karteck/rover-autonome/README.md

# rover-autonome
Devellopement d'un rover autonome dans le cadre de l'alternance au Lab-STICC lors du Master 2
