karteck/rover-autonome/rosbag/README.md

## Description des rosbag enregistrées

|Nom|Description|
|---|---|
|imu1_data.bag & imu2_data.bag|Enregistrement de 3 heures avec deux centrales MPU6050 différentes, immobiles, et côtes à côtes.|

kjjtyfkgfhg
