karteck/rover-autonome/archive/Document de dev/Débogage robot alu.docx

Ludovic Chavalarias, Lab-STICC, 2022

# Débogage

## Marquer les zones inconnue d’une carte comme infranchissable

Dans le fichier « base_local-planner_default_params.yaml », ajouter la ligne allow_unknown : false. Cela a pour effet d’interdire la planification de trajet à travers les zones inconnue de la carte. Dans le labo, cela est utile au niveau des vitres.

Dans le fichier « cosmap_common_params.yaml » ajouter une « layer » :

obstacle_layer :

observation_sources : scan

scan :

data_type : LaserScan

topic : scan

marking : true

clearing : true

track_unknown_space : true

## Augmenter la sécurité du robot

Jouer avec les parametres inflation_radius et cost_scaling_factor afin d’augmenter la distance au obstacles.

Augmentation aussi de l’empreinte du robot pour ajouter une distance de « sécurité ». De manière général, l’empreinte devrait toujours être un peu plus grande que le robot lui-même.

## Paquet waypoints saute des points

On détermine à quoi serve les topics :

/waypoint_server/statusgoal | Indique si le l’objectif actuel est un succès ou non. Reçois un message seulement pour indiquer si est but est accomplis ou non. Ne reçois pas de message pendant l’accomplissement de l’objectif.
/waypoint_server/waypoints
/waypoint_server/waypoints_gr | Nom du groupe et liste des points que le robot est en train de parcourir
/move_base/current_goal | Position que le robot veut atteindre. Reçois un message à chaque nouvelle objectif reçu
/move_base/result | Indique qu’un objectif ait été atteint (status = 3)
/move_base/status | Liste de status de l’objectif actuel : - 1 : objectif accepté - 4 : abandon après que toutes les tentatives de déblocages aient échouées
/move_base/recovery_status | Reçois des messages lorsque des tentatives de déblocage sont en cours.

Observation : Dans le fichier tour_bug_skipEtRecovery.bag, le bug peut être observé, c’est le point au niveau de la pause IRDL qui est sauté. Lorsque le robot arrive au point de passage le précédent, le topic /move_base/status comporte deux entrées : reached et goal accepted. Cependant il comporte ensuite 3 entrées : deux reached et une goal accepted. Cela confirme que le point est accepté puis directement considérer comme atteint

Résolution :

Problème similaire : https://github.com/ros-planning/navigation/issues/949

On fait les modifications du lien au-dessus dans les fichier move_base.cpp et move_base.h

## Le robot est bloqué à un point et les resets ne fonctionnent pas

- amcl.launch
  - laser_likeihood_max_dist = 4 from 2
  - laser_siglma_hit = 0.1 from 0.2
  - laser_z_hit = 0.9 from 0.5

Il se peut que les costmap ne soit pas réellement reset lors des tentatives de recovers. Dans le fichier tour_bug_skipEtRecovery.bag le bug est observable au niveau du bureau des ingés. Au moment du bug les costmap ont été reset de façon manuelle via un appel au service /move_base/clear_local_costmap. On peut voir que le robot reprend sa route.

Reproduire le bug

Lorsque le robot se déplace, il update sa carte avec les obstacles qu’il voie. Le problème est que les obstacles qu’il a vus reste dans la carte une fois que le robot s’est éloigné. C’est pour cela qu’il bug parfois au niveau du bureau des ingé.

Pour le reproduire, il suffit de se tenir dans l’encadrement de la porte du bureau pendant que le robot s’éloigne. Il va considérer que des obstacles bloque le passage. Arrivé au bureau des ingés, il ne pour donc pas trouver de chemin vers le bureau SHAKER.

Pour faire le tour sans problème, il suffit de ne pas se tenir dans l’encadrement de la porte pendant que le robot s’éloigne.

Ce comportement est observable dans les enregistrements « tour_bureau_2.bag » et « tour_bug_recovery.bag »

Correction

Le problème vient des configurations pre-hydro utilisées par défaut. Pour corriger le phénomène, il faut modifier les fichiers suivant :

- local_costmap_param.yaml en ajoutant :

plugins :

{name : obstacle_layer, type : “costmap_2d::ObstacleLayer”}

{name : inflation_layer, type : “costmap_2d::InflationLayer”}

obstacle_layer :

observation_sources : scan

scan :

data_type : LaserScan

topic : scan

marking : true

clearing : true

track_unknown_space : true

inflation_layer:

inflation_radius: 1.2

cost_scaling_factor: 3

- global_cosmap_param.yaml en ajoutant :

plugins :

{name : static_layer, type : “costmap_2d::StaticLayer”}

{name : obstacle_layer, type : “costmap_2d::ObstacleLayer”}

{name : inflation_layer, type : “costmap_2d::InflationLayer”}

obstacle_layer :

observation_sources : scan

scan :

data_type : LaserScan

topic : scan

marking : false

clearing : true

track_unknown_space : true

- costmap_common_params.yaml en déclarant les « layers » :

static_layer :

map_topic : map

inflation_layer:

inflation_radius: 1.2

cost_scaling_factor: 3

Effet : de cette façon les couches sont déclarées et utiliser grâce à la déclaration des plugins. Cela permet de les configurer comme on le souhaite, étant donné que le problème venait de la configuration par défaut.

Le résultat est que les obstacles observés par le Lidar sont supprimés de la costmap une fois que le robot s’est éloigné.
