karteck/rover-autonome/archive/Document de dev/réglagePID.docx

Réglage du PID

Pierre Bomel, Université de Bretagne Sud, Lab-STICC, Lorient, France, mai 2021

Tests pour le KP

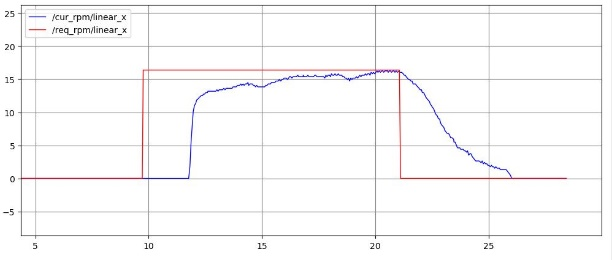
[picture p12: figure]
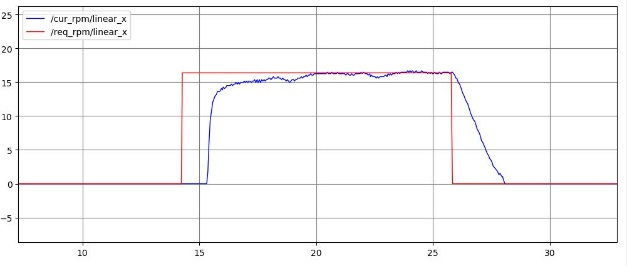
[picture p13: figure]

KP = 0.1 KP = 0.2

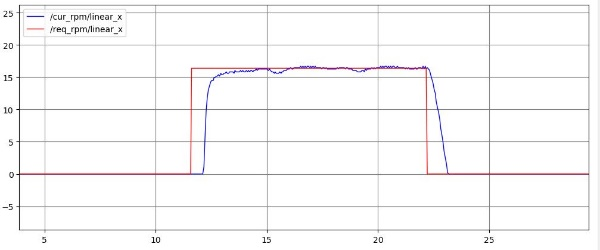
[picture p14: figure]
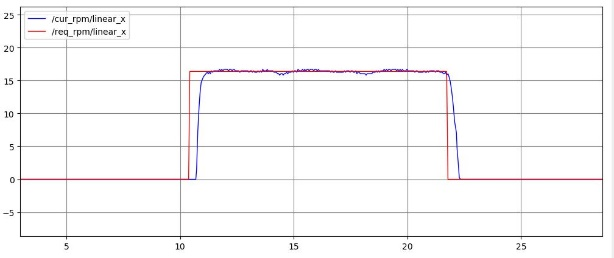
[picture p15: figure]

KP = 0.4 KP = 0.8

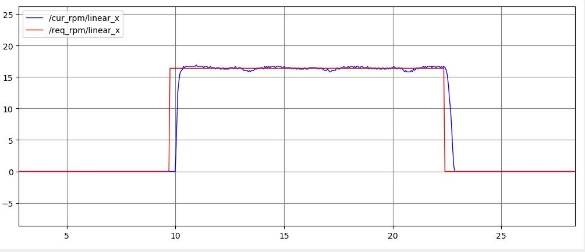
[picture p16: figure]
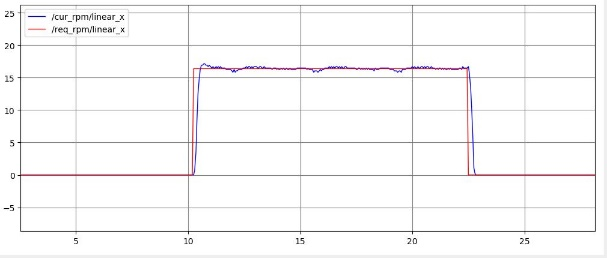
[picture p17: figure]

KP = 1.0 KP = 2.0

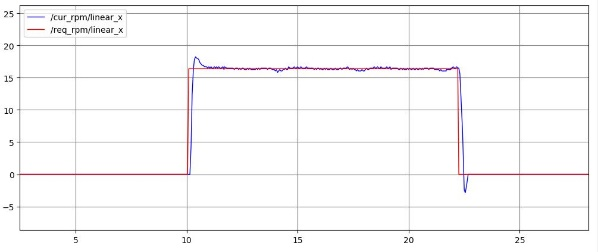
[picture p18: figure]
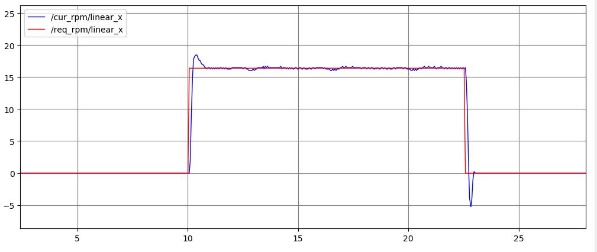
[picture p19: figure]

KP = 3.0 KP = 4.0

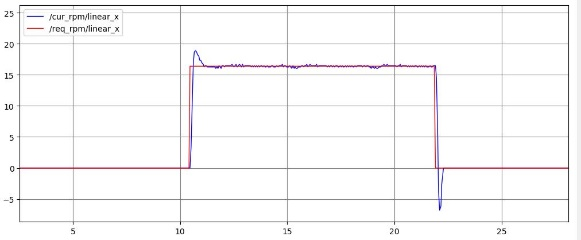
[picture p20: figure]
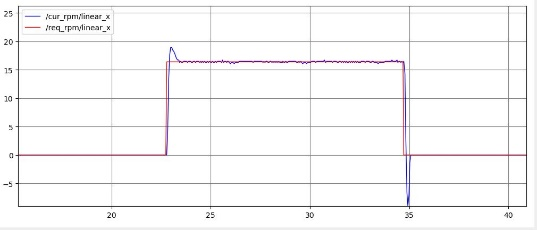
[picture p21: figure]

KP = 5.0 KP = 6.0

Choix => KP = 1.0

Tests pour KD (KP = 1.0)

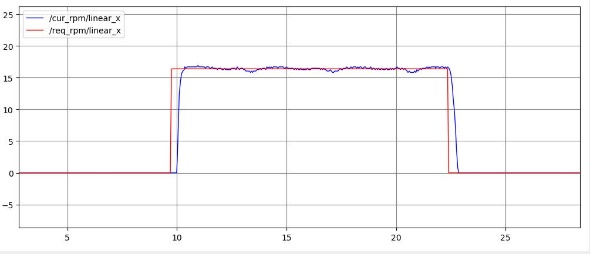
[picture p22: figure]
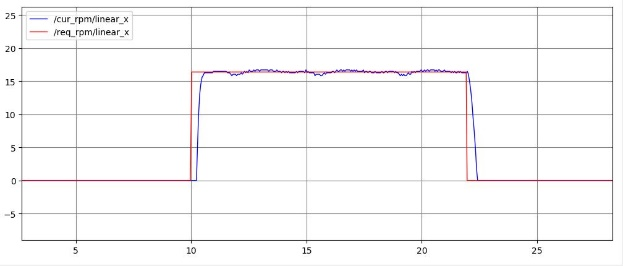
[picture p23: figure]

KD = 0.0 KD = 0.1

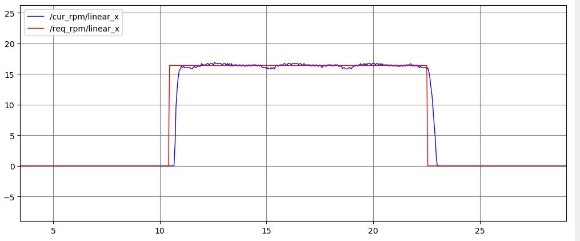
[picture p24: figure]
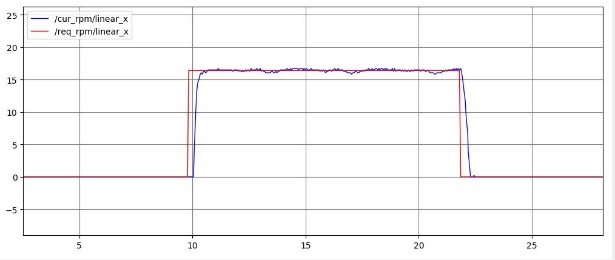
[picture p25: figure]

KD = 0.2 KD = 0.4

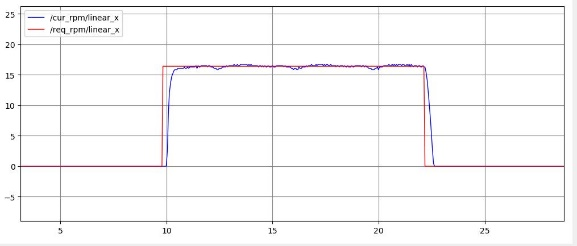
[picture p26: figure]

KD = 0.8 Pas de différences notables => KD = 0.1

Tests pour KI (KP = 1.0, KD = 0.1)

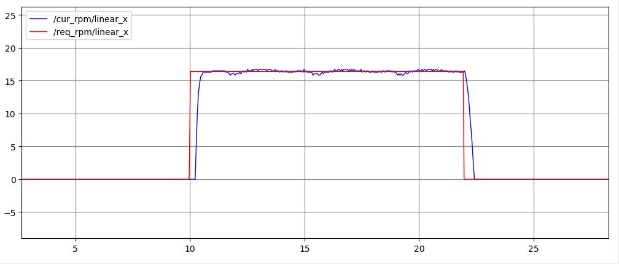
[picture p27: figure]
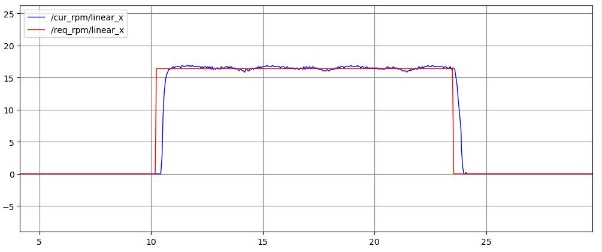
[picture p28: figure]

KI = 0.0 KI = 0.001

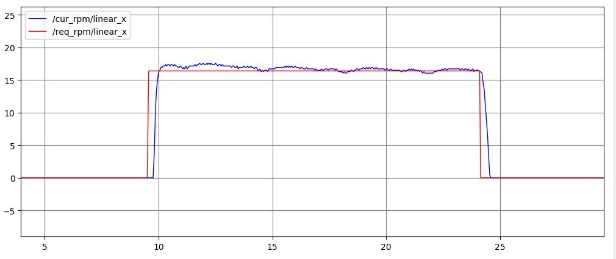
[picture p29: figure]
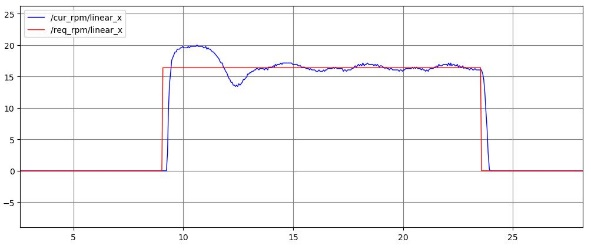
[picture p30: figure]

KI = 0.01 KI = 0.1

Choix => KI = 0.001

Tests pour KD (KP = 3.0)

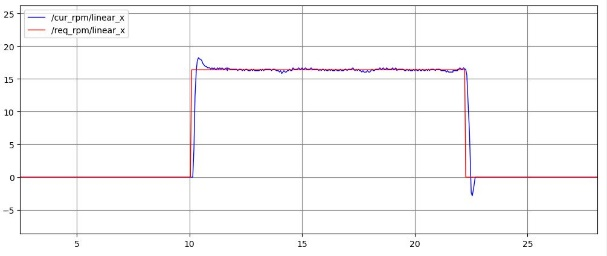
[picture p31: figure]
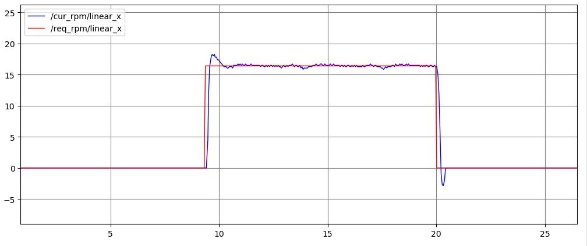
[picture p32: figure]

KD = 0.0 KD = 0.1

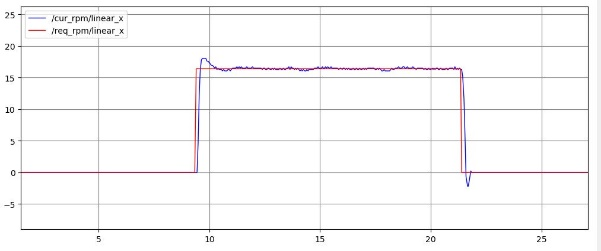
[picture p33: figure]
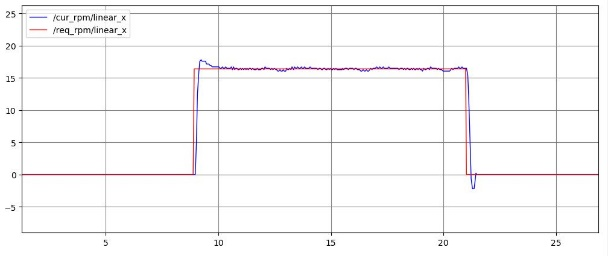
[picture p34: figure]

KD = 0.2 KD = 0.4

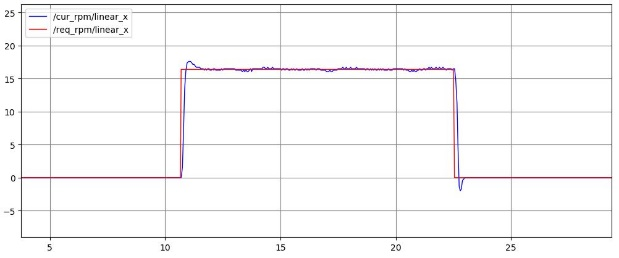
[picture p35: figure]
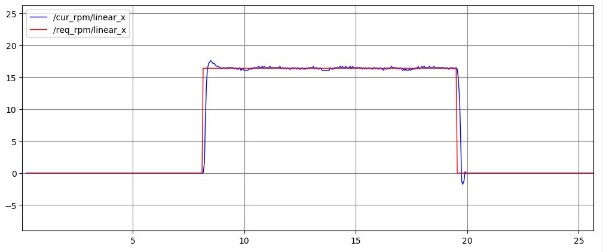
[picture p36: figure]

KD = 0.8 KD = 1.0

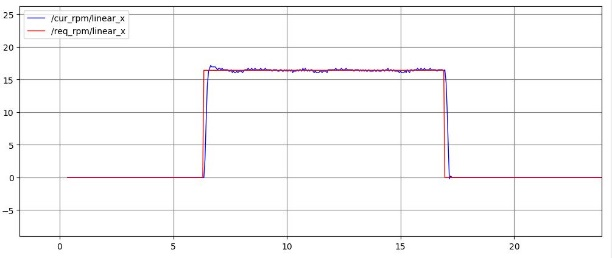
[picture p37: figure]
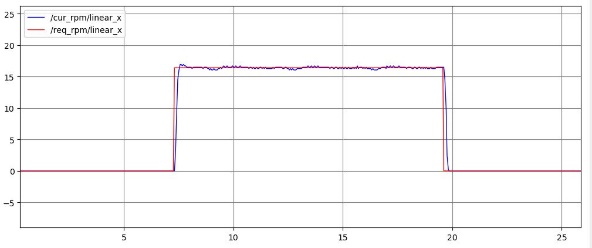
[picture p38: figure]

KD = 1.5 KD = 2.0

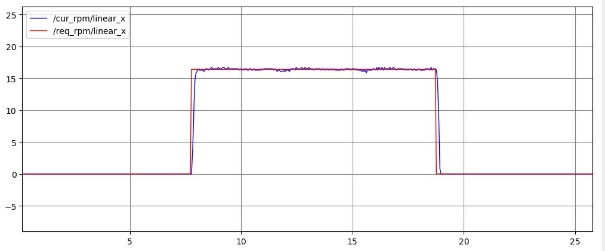
[picture p39: figure]
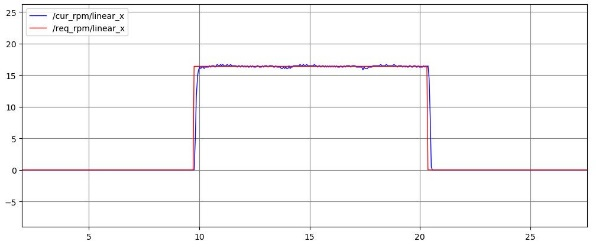
[picture p40: figure]

KD = 2.5 KD = 3.0

Choix => KD = 2.5

Tests pour KI (KP = 3.0, KD = 2.5)

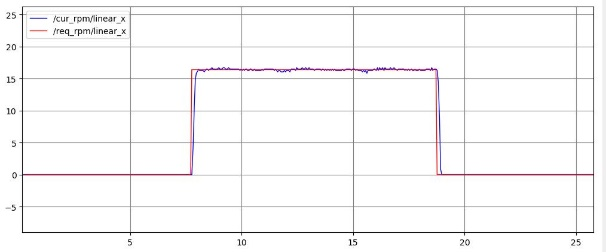
[picture p41: figure]
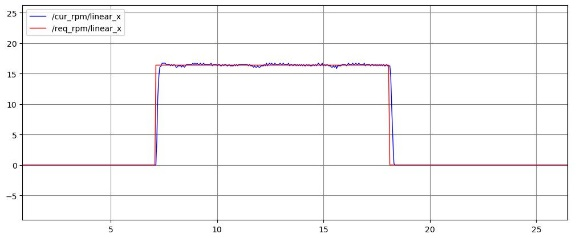
[picture p42: figure]

KI = 0.0 KI = 0.001

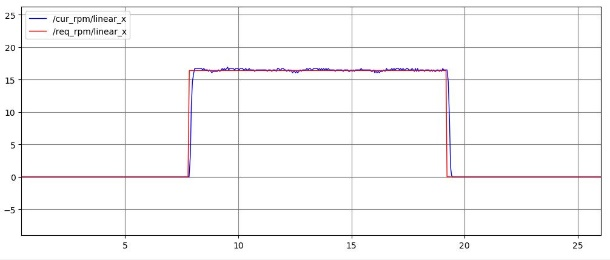
[picture p43: figure]
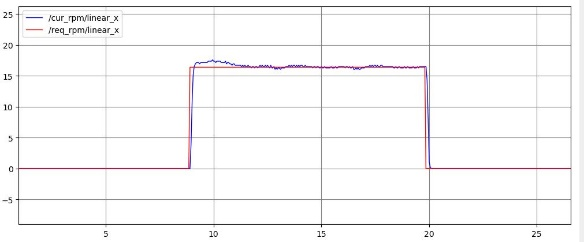
[picture p44: figure]

KI = 0.01 KI = 0.1

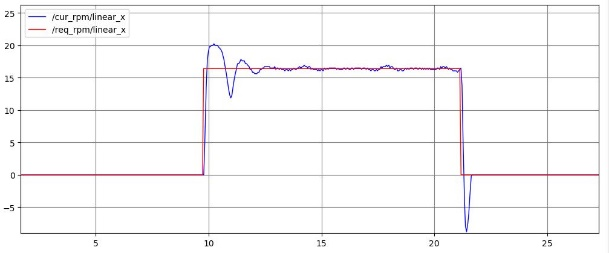
[picture p45: figure]

KI = 1.0

Choix => KI = 0.001
