karteck/rover-autonome/(commit log)

2022-04-28 ajout des rosbag
2022-04-28 ajout de la carte
